teco-kit/Jennisense/README

A modularized open hardware, sensor drivers based on contiki for the JN51xx µController. A detailed description and how-to can be found in the wiki (see link below).
http://github.com/teco-kit/Jennisense/wiki
