teco-kit/Jennisense/hardware/jnode/jnode_v34.html

Stückliste exportiert aus /home/phil/teco/jennisense/hardware/jnode/jnode_v34.sch am 08.07.14 09:46

Qty | Value | Device | Package | Parts | Description | ARROW | DIGIKEY | FARNELL | MOUSER | PLACE
1 | | JENNIC_JN51XXSMDTH | JN5148_SMDTH | IC1 | JN5139-xxx-M00xxx, Farnell: 1500175 | | 616-1045-1-ND | | | no
1 | | JUMPER-2SMD-NC | SJ_2S | JP2 | Jumper
1 | | JUMPER-2SMD-NO | SJ_2S-NO | JP1 | Jumper | | | | | no
3 | | LEDGL100MD1MP1 | GL100MD1MP1 | LED3; LED4; LED5 | LED | | | http://de.farnell.com/sharp/gl100md1mp1/ir-emitter-smd-940nm/dp/9707816?Ntt=970-7816 | | no
1 | | MOLEX_47309-2651NEW | MOLEX_47309-2651 | MICRO_SD1 | | | WM3974CT-ND
6 | 0.1µF | CAP0402-CAP | 0402-CAP | C2; C5; C6; C8; C12; C14 | Capacitor | | 490-1318-1-ND
3 | 0.1µF | CAP0402-CAP | 0402-CAP | C4; C13; C18 | Capacitor | | 490-1318-1-ND | | | no
1 | 0.22µF | CAP0402-CAP | 0402-CAP | C11 | Capacitor | | 399-4886-1-ND
1 | 1.5M | RESISTOR0402-RES | 0402-RES | R7 | Resistor | | 311-1.5MJRCT-ND
1 | 1.8k | RESISTOR0402-RES | 0402-RES | R2 | Resistor | | 311-1.8KJRCT-ND
3 | 10k | RESISTOR0402-RES | 0402-RES | R6; R10; R11 | Resistor | | RHM10.0KCDCT-ND
1 | 10pF | CAP0402-CAP | 0402-CAP | C10 | Capacitor | | 311-1014-1-ND
6 | 10µF | CAP0603-CAP | 0603-CAP | C9; C15; C17; C19; C20; C22 | Capacitor | | 445-7454-1-ND
1 | 1M | RESISTOR0402-RES | 0402-RES | R9 | Resistor | | 311-1.00MLRCT-ND
1 | 1µF | CAP0402-CAP | 0402-CAP | C7 | Capacitor | | 490-1320-1-ND
1 | 2.2µF | CAP0402-CAP | 0402-CAP | C21 | Capacitor | | 445-7396-1-ND
2 | 22 | RESISTOR0402-RES | 0402-RES | R4; R5 | Resistor | | 311-22JRCT-ND
2 | 3k3 | RESISTOR0402-RES | 0402-RES | R18; R19 | Resistor | | 1276-3460-1-ND
1 | 4.7µF | CAP0402-CAP | 0402-CAP | C3 | Capacitor | | 1276-1056-1-ND
1 | 4.7µH | SPARKFUN_INDUCTOR | MLP2012 | L1 | Inductors | | 445-6366-1-ND
1 | 470nF | CAP0402-CAP | 0402-CAP | C1 | Capacitor | | 587-1230-1-ND
3 | 510 | RESISTOR0402-RES | 0402-RES | R15; R16; R17 | Resistor | | | | | no
1 | 560K | RESISTOR0402-RES | 0402-RES | R8 | Resistor | | P560KLCT-ND
2 | 680 | RESISTOR0402-RES | 0402-RES | R3; R12 | Resistor | | RHM680CDCT-ND
1 | ATMEGA32U4-AUQFN44 | ATMEGA32U4-AUQFN44 | QFN44 | IC2 | | | ATMEGA32U4-MU-ND
1 | DMP2104LP-7 | DMP2104LP-7 | DFN1411-3 | T1 | | | DMP2104LPDICT-ND
1 | GREEN | LEDCHIP-LED0402 | CHIP-LED0402 | LED2 | LED | | 754-1127-1-ND
1 | LSM9D | LSM9D | LGA4X4 | U2 | | http://components.arrow.com/part/search/lsm9ds0 | http://www.digikey.com/product-detail/en/LSM9DS0TR/497-13902-1-ND/4311634 | | http://de.mouser.com/ProductDetail/STMicroelectronics/LSM9DS0TR/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
1 | LTC2942-1 | LTC2942-1 | DFN6 | U4 | LTC2942-1/2 | | LTC2942IDCB-1#TRMPBFCT-ND
1 | LTC3553 | LTC3553 | QFN20 | IC3 | | | LTC3553EUD#PBF-ND
1 | MPL3115A2 | MPL3115A2 | LGA8 | IC6 | | | MPL3115A2-ND
1 | RED | LEDCHIP-LED0402 | CHIP-LED0402 | LED1 | LED | | 754-1128-1-ND
1 | RESONATORPRQC-S | RESONATORPRQC-S | PRQC | U6 | Ceramic Resonator with caps | | 478-5420-1-ND
1 | SFV5R | SFV5R | SFV5R | U3 | | | 609-4330-1-ND
1 | SHT21 | SHT21 | DFN300X300X110-7N | U1 | SENSOR, HUMIDITY & TEMP | | | http://de.farnell.com/sensirion/sht21/sensor-feuchte-temp-3x3mm-2/dp/1855468?Ntt=1855468
1 | TACTILE_SWITCH | TACTILE_SWITCH | EVQ-PUK02K | BTN_PWR | collection of tactile switches | | P10852SCT-ND
1 | TECO-LOGO | TECO-LOGO | TECO-LOGO | U$9 | | | | | | no
1 | USBMICROB-XT | USBMICROB-XT | USB-MICROB-XT | X1 | USB Connectors | | H11635CT-ND
1 | VCNL4000 | VCNL4000 | VNCL4000 | VCNL4010 | | | VCNL4010-GS08CT-ND
