teco-kit/Jennisense/hardware/jnode/jnode_v3_links.htm

Stückliste exportiert aus /home/phil/teco/jennisense/hardware/jnode/jnode_v3.sch am 16.08.12 17:53

Qty | Value | Device | Package | Parts | Description | DIGIKEY | FARNELL | FUTUREELECTRIC | IPODCONN | MF | MPN | OC_FARNELL | OC_NEWARK | PLACE | TECO
1 | | JUMPER-2SMD-NO | SJ_2S-NO | JP1 | Jumper
3 | | LEDGL100MD1MP1 | GL100MD1MP1 | LED3, LED4, LED5 | LED | | link (http://de.farnell.com/sharp/gl100md1mp1/ir-emitter-smd-940nm/dp/9707816?Ntt=970-7816) | | | | | | | no
6 | 0.1µF | CAP0402-CAP | 0402-CAP | C2, C4, C8, C12, C14, C18 | Capacitor | link (http://search.digikey.com/scripts/DkSearch/dksus.dll?Detail&name=445-7396-1-ND) | link (http://de.farnell.com/multicomp/mcca000051/mlcc-04025v-16v-100nf/dp/1758897) | | | | | | | | yes
1 | 0.22µF | CAP0402-CAP | 0402-CAP | C16 | Capacitor | link (http://search.digikey.com/scripts/DkSearch/dksus.dll?Detail&name=311-1350-1-ND) | link (http://de.farnell.com/multicomp/mcca000036/mlcc-04025v-10v-220nf/dp/1758880) | | | | | | | | yes
1 | 1.5M | RESISTOR0402-RES | 0402-RES | R7 | Resistor | link (http://search.digikey.com/scripts/DkSearch/dksus.dll?Detail&name=541-2.20MLCT-ND) | link (http://de.farnell.com/yageo-phycomp/rc0402fr-071m8l/widerstand-0402-0-063w-1-1m8/dp/1458753) | | | | | | | | yes
1 | 1.8k | RESISTOR0402-RES | 0402-RES | R2 | Resistor | link (http://search.digikey.com/scripts/DkSearch/dksus.dll?Detail&name=311-1.8KJRCT-ND) | link (http://de.farnell.com/vishay-draloric/crcw04021k80fkeahp/widerstand-0402-1-1k80/dp/1738853) | | | | | | | | yes
4 | 10k | RESISTOR0402-RES | 0402-RES | R1, R6, R10, R11 | Resistor | link (http://search.digikey.com/scripts/DkSearch/dksus.dll?Detail&name=311-10KJRCT-ND) | link (http://de.farnell.com/bourns/cr0603-jw-103elf/widerstand-0603-10k-5-0-1w/dp/2008360) | | | | | | | | yes
1 | 10nF | CAP0402-CAP | 0402-CAP | C11 | Capacitor | link (http://search.digikey.com/scripts/DkSearch/dksus.dll?Detail&name=478-1114-1-ND) | link (http://de.farnell.com/multicomp/mcca000076/mlcc-0402-x7r-25v-10nf/dp/1758924) | | | | | | | | yes
1 | 10pF | CAP0402-CAP | 0402-CAP | C10 | Capacitor | link (http://search.digikey.com/scripts/DkSearch/dksus.dll?Detail&name=311-1014-1-ND) | link (http://de.farnell.com/multicomp/mcca000091/mlcc-0402-np0-50v-10pf/dp/1758941) | | | | | | | | yes
4 | 10µF | CAP0603-CAP | 0603-CAP | C9, C13, C17, C22 | Capacitor | link (http://search.digikey.com/scripts/DkSearch/dksus.dll?Detail&name=445-7454-1-ND) | link (http://de.farnell.com/multicomp/mcca000517/mlcc-0603-x5r-6-3v-10uf/dp/1759393) | | | | | | | | yes
2 | 10µF / near | CAP0603-CAP | 0603-CAP | C19, C20 | Capacitor | link (http://search.digikey.com/scripts/DkSearch/dksus.dll?Detail&name=445-7454-1-ND) | link (http://de.farnell.com/multicomp/mcca000517/mlcc-0603-x5r-6-3v-10uf/dp/1759393) | | | | | | | | yes
2 | 1M | RESISTOR0402-RES | 0402-RES | R9, R14 | Resistor | link (http://search.digikey.com/scripts/DkSearch/dksus.dll?Detail&name=311-10KJRCT-ND) | link (http://de.farnell.com/bourns/cr0603-jw-103elf/widerstand-0603-10k-5-0-1w/dp/2008360) | | | | | | | | yes
3 | 1µF | CAP0402-CAP | 0402-CAP | C5, C6, C7 | Capacitor | link (http://search.digikey.com/scripts/DkSearch/dksus.dll?Detail&name=490-1320-1-ND) | link (http://de.farnell.com/multicomp/mcca000500/mlcc-0402-x5r-6-3v-1uf/dp/1759375) | | | | | | | | yes
1 | 2.2M | RESISTOR | 0805 | R13 | Resistor | link (http://search.digikey.com/scripts/DkSearch/dksus.dll?Detail&name=541-2.20MLCT-ND) | link (http://de.farnell.com/te-connectivity-cgs/rh73u2a2m2jtd/widerstand-0805-2m2/dp/1174056)
1 | 2.2µF / near | CAP0402-CAP | 0402-CAP | C21 | Capacitor | link (http://search.digikey.com/scripts/DkSearch/dksus.dll?Detail&name=445-7396-1-ND) | link (http://de.farnell.com/multicomp/mcca000501/mlcc-0402-x5r-6-3v-2-2uf/dp/1759376RL) | | | | | | | | yes
2 | 22 | RESISTOR0402-RES | 0402-RES | R4, R5 | Resistor | link (http://search.digikey.com/scripts/DkSearch/dksus.dll?Detail&name=311-22JRCT-ND) | link (http://de.farnell.com/multicomp/mc-0-0625w-0402-1-22r/widerstand-0402-1-22r/dp/1357998)
2 | 3k3 | RESISTOR0402-RES | 0402-RES | R18, R19 | Resistor | link (http://search.digikey.com/scripts/DkSearch/dksus.dll?Detail&name=541-2.20MLCT-ND) | link (http://de.farnell.com/bourns/cr0603-jw-103elf/widerstand-0603-10k-5-0-1w/dp/2008360) | | | | | | | no | yes
1 | 4.7µF | CAP0402-CAP | 0402-CAP | C15 | Capacitor | link (http://search.digikey.com/scripts/DkSearch/dksus.dll?Detail&name=490-5408-1-ND) | link (http://de.farnell.com/avx/04024d475mat2a/kondensator-0402-x5r-4v-4-7uf/dp/1833801) | | | | | | | | yes
1 | 4.7µH | SPARKFUN_INDUCTOR | MLP2012 | L1 | Inductors | link (http://search.digikey.com/scripts/DkSearch/dksus.dll?Detail&name=445-6366-1-ND)
2 | 470nF | CAP0402-CAP | 0402-CAP | C1, C3 | Capacitor | link (http://search.digikey.com/scripts/DkSearch/dksus.dll?Detail&name=311-1334-1-ND) | link (http://de.farnell.com/multicomp/mcca000510/mlcc-0402-x5r-16v-0-047uf/dp/1759386) | | | | | | | | yes
3 | 510 | RESISTOR0402-RES | 0402-RES | R15, R16, R17 | Resistor | | | | | | | | | no
1 | 53261-03 | 53261-03 | 53261-03 | X2 | CONNECTOR | | | | link (http://www.batteryspace.com/li-ionbatterymodule37v500mahwithpcb043144foripodmini185wh.aspx) | MOLEX | 53261-0390 | 1125359 | 57H5006
1 | 560K | RESISTOR0402-RES | 0402-RES | R8 | Resistor | link (http://search.digikey.com/scripts/DkSearch/dksus.dll?Detail&name=RMCF0402FT698KCT-ND) | link (http://de.farnell.com/yageo-phycomp/rc0402jr-07560kl/widerstand-rc31-0402-560k/dp/9233091)
2 | 680 | RESISTOR0402-RES | 0402-RES | R3, R12 | Resistor | link (http://search.digikey.com/scripts/DkSearch/dksus.dll?Detail&name=311-39JRCT-ND)
1 | ATMEGA32U4-AUQFN44 | ATMEGA32U4-AUQFN44 | QFN44 | IC2 | | link (http://search.digikey.com/scripts/DkSearch/dksus.dll?Detail&name=ATMEGA32U4-MU-ND)
1 | DMP2104LP-7 | DMP2104LP-7 | DFN1411-3 | T1
1 | GREEN | LEDCHIP-LED0402 | CHIP-LED0402 | LED2 | LED | link (http://search.digikey.com/scripts/DkSearch/dksus.dll?Detail&name=754-1128-1-ND) | | | | | | | | | yes
1 | JENNIC_JN5139 | JENNIC_JN51XXSMDTH | JN5148_SMDTH | IC1 | JN5139-xxx-M00xxx, Farnell: 1500175 | link (http://search.digikey.com/de/de/products/JN5148%2F001M00T,534/616-1045-1-ND/2139684) | | link (http://de.futureelectronics.com/de/technologies/semiconductors/microcontrollers/32-bit/Seiten/6004977-JN5148-001M00T,534.aspx) | | | | | | | yes
1 | L3G4200D | L3G4200D | LGA16-4X4 | IC5 | L3G4200D Three-axis, digital output gyroscope | link (http://search.digikey.com/scripts/DkSearch/dksus.dll?Detail&name=497-11071-1-ND) | link (http://de.farnell.com/stmicroelectronics/l3g4200d/gyro-mems-3achsen-16llga-16lga/dp/1872924?Ntt=l3g4200) | link (http://de.futureelectronics.com/de/technologies/semiconductors/analog/sensors/motion/Seiten/2007852-L3G4200DTR.aspx)
1 | LSM303DLM | LSM303LGA28_LONG | LGA28 | IC4 | LSM303DLH | link (http://search.digikey.com/scripts/DkSearch/dksus.dll?Detail&name=497-11240-1-ND) | | link (http://de.futureelectronics.com/de/technologies/semiconductors/analog/sensors/accelerometers/Seiten/8010012-LSM303DLMTR.aspx)
1 | LTC3553 | LTC3553 | QFN20 | IC3 | | link (http://search.digikey.com/scripts/DkSearch/dksus.dll?Detail&name=LTC3553EUD%23PBF-ND)
1 | MPL115A | MPL115A | LGA8 | IC6 | MPL115A1 (SPI) and MPL115A2 (I2C) | link (http://search.digikey.com/scripts/DkSearch/dksus.dll?Detail&name=MPL115A2T1CT-ND) | | | | | | | | | yes
1 | RED | LEDCHIP-LED0402 | CHIP-LED0402 | LED1 | LED | link (http://search.digikey.com/scripts/DkSearch/dksus.dll?Detail&name=754-1128-1-ND) | | | | | | | | | yes
1 | RESONATORPRQC-S | RESONATORPRQC-S | PRQC | U$6 | Ceramic Resonator with caps | link (http://search.digikey.com/scripts/DkSearch/dksus.dll?Detail&name=478-5420-1-ND)
1 | SENSOR_BOARD_MOLEX_47309-2651'NEW' | SENSOR_BOARD_MOLEX_47309-2651'NEW' | SENSOR_BOARD_MOLEX_47309-2651 | MICRO_SD1 | | link (http://search.digikey.com/scripts/DkSearch/dksus.dll?Detail&name=WM3974CT-ND) | | | | | | | | | yes
1 | SONDER_H_VIBRATIONSSCHALTER | SONDER_H_VIBRATIONSSCHALTER | SONDER_H_VIBSCHALTER | SW1 | Vibrationsschalter von FZK
1 | TACTILE_SWITCH | TACTILE_SWITCH | EVQ-PUK02K | BTN_PWR | collection of tactile switches | link (http://search.digikey.com/scripts/DkSearch/dksus.dll?Detail&name=P10852SCT-ND)
1 | TECO-LOGO | TECO-LOGO | TECO-LOGO | U$9
1 | USB-MICROB | USB-MICROB | USB-MICROB | X1 | USB Connectors | link (http://search.digikey.com/scripts/DkSearch/dksus.dll?Detail&name=H11635CT-ND)
1 | VCNL4000 | VCNL4000 | VNCL4000 | VCNL4000 | | link (http://search.digikey.com/scripts/DkSearch/dksus.dll?Detail&name=751-1505-1-ND) | | | | | | | | | yes
