teco-kit/Jennisense/hardware/jncc3000/jncc3000-bom.pdf

19.4.2014 | jncc3000_links.html
file:///home/phil/teco/jennisense/hardware/jncc3000/jncc3000_links.html | 1/1

Stückliste exportiert aus /home/phil/teco/jennisense/hardware/jncc3000/jncc3000.sch am 19.04.14 13:14

Part Value Device | Package | Description | COMMENT DIGIKEY MOUSER PLACE
ANT1 AT8010 AT8010 | AT8010 | AT8010 Series Multilayer Chip Antenna | link (http://www.digikey.de/product-detail/en/2500AT44M0400E/712-1403-1-ND/1840081) | link (http://de.mouser.com/ProductDetail/Johanson/2500AT44M0400E/)
C3 | 100nF C-EUC0603 | C0603 | CAPACITOR, European symbol | link (http://www.digikey.de/product-detail/en/CC0603KRX7R8BB104/311-1341-1-ND/2103125) | link (http://de.mouser.com/ProductDetail/Vishay-Vitramon/VJ0603Y104JXJCW1BC/)
C4 | 0.8pF C-EUC0603 | C0603 | CAPACITOR, European symbol | RF Capacitor
| | | | link (http://www.digikey.de/product-detail/en/251R14S0R8BV4T/712-1305-1-ND/1786767) | link (http://de.mouser.com/ProductDetail/Johanson/251R14S0R8BV4T/)
L1 | 3.3nH INDUCTOR0603 | 0603 | Inductors | RF Inductor link (http://www.digikey.de/product-detail/en/L-14C3N3SV4T/712-1428-1-ND/1914878) | link (http://de.mouser.com/ProductDetail/Johanson/L-14C3N3SV4T/)
U$2 | JENNIC_JN51XXTH JN5139_TH | JN5139-xxx-M00xxx, Farnell: 1500175 | no
U1 | CC3000 | CC3000 | | link (http://www.digikey.de/product-detail/en/CC3000MODR/296-35512-1-ND/3768439) | link (http://de.mouser.com/ProductDetail/Texas-Instruments/CC3000MOD/?qs=sGAEpiMZZMul4LbMdexInYO9dzLxESeK)
U4 | NL17SZ125SOT553 SOT-553 | link (http://www.digikey.de/product-detail/en/NL17SZ125XV5T2G/NL17SZ125XV5T2GOSCT-ND/3462428) | link (http://de.mouser.com/ProductDetail/ON-Semiconductor/NL17SZ125XV5T2G/)
X2 | IPEX-20279-001E | IPEX-20279- 001E | Ultra Miniature Coaxial SMT RF Receptacle
no
