teco-kit/Jennisense/hardware/jnode/case.stl

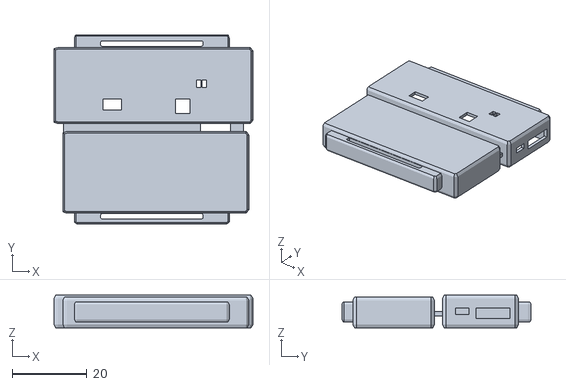
[picture p1: CAD file, 2014-07-05]
hardware/jnode/case.stl
53.3 x 50.7 x 8.73
