teco-kit/Jennisense/hardware/jncc3000/jncc3000-schematic.pdf

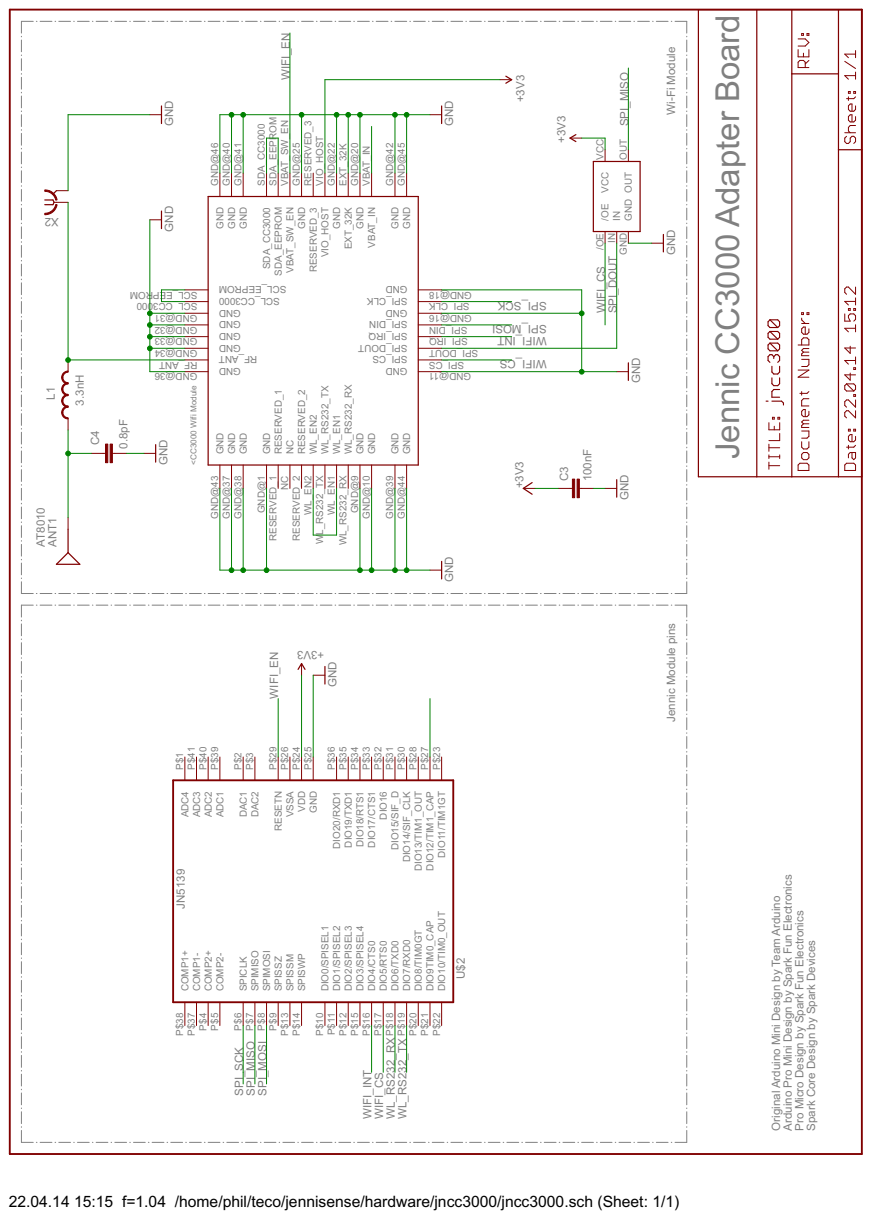
[picture p2: page 1]

Wi-Fi Module Jennic Module pins

GND GND@40 GND GND@41

GND GND@20 GND GND@22 GND GND@25

GND GND@44 GND GND@45

IN OUT OUT VCC

GND GND@9 GND GND@10 DNG

GND GND@37 GND GND@38

Arduino Arduino Pro Mini Design by Spark Fun Electronics Pro Micro Design by Spark Fun Electronics Spark Core Design by Spark Devices J

Original Arduino Mini Design by Team

22.04.14 15:15 f=1.04 /home/phil/teco/jennisense/hardware/jncc3000/jncc3000.sch (Sheet: 1/1)
