teco-kit/Jennisense/hardware/jncc3000/jncc3000-board.pdf

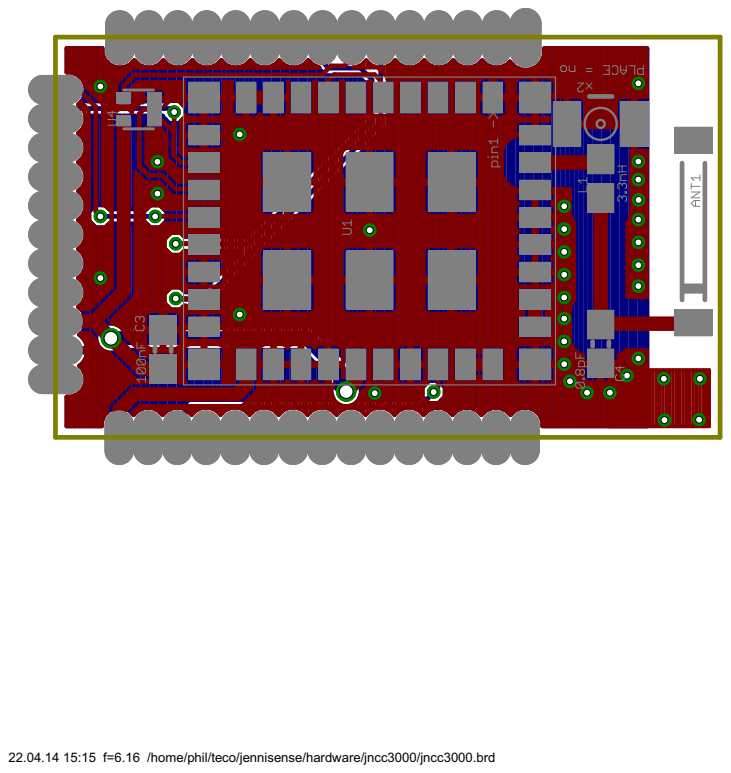
[picture p3: page 1]

22.04.14 15:15 f=6.16 /home/phil/teco/jennisense/hardware/jncc3000/jncc3000.brd
