teco-kit/Jennisense/hardware/jncc3000/jncc3000-assembly.pdf

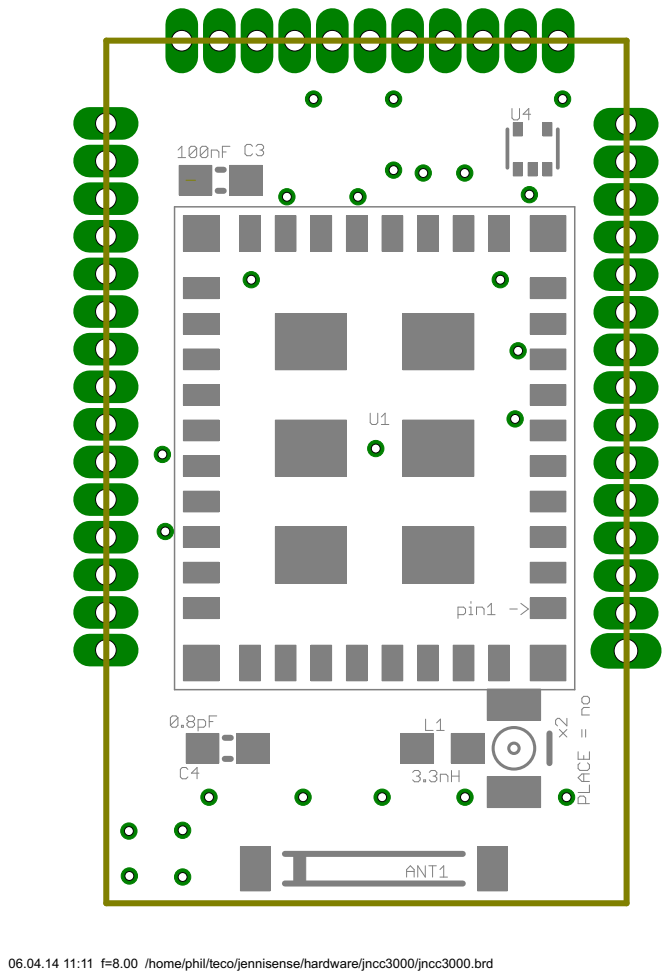
[picture p4: page 1]

06.04.14 11:11 f=8.00 /home/phil/teco/jennisense/hardware/jncc3000/jncc3000.brd
