teco-kit/Jennisense/hardware/jnode/jnode_v34.brd

## EAGLE design hardware/jnode/jnode_v34.brd (2014-08-19)

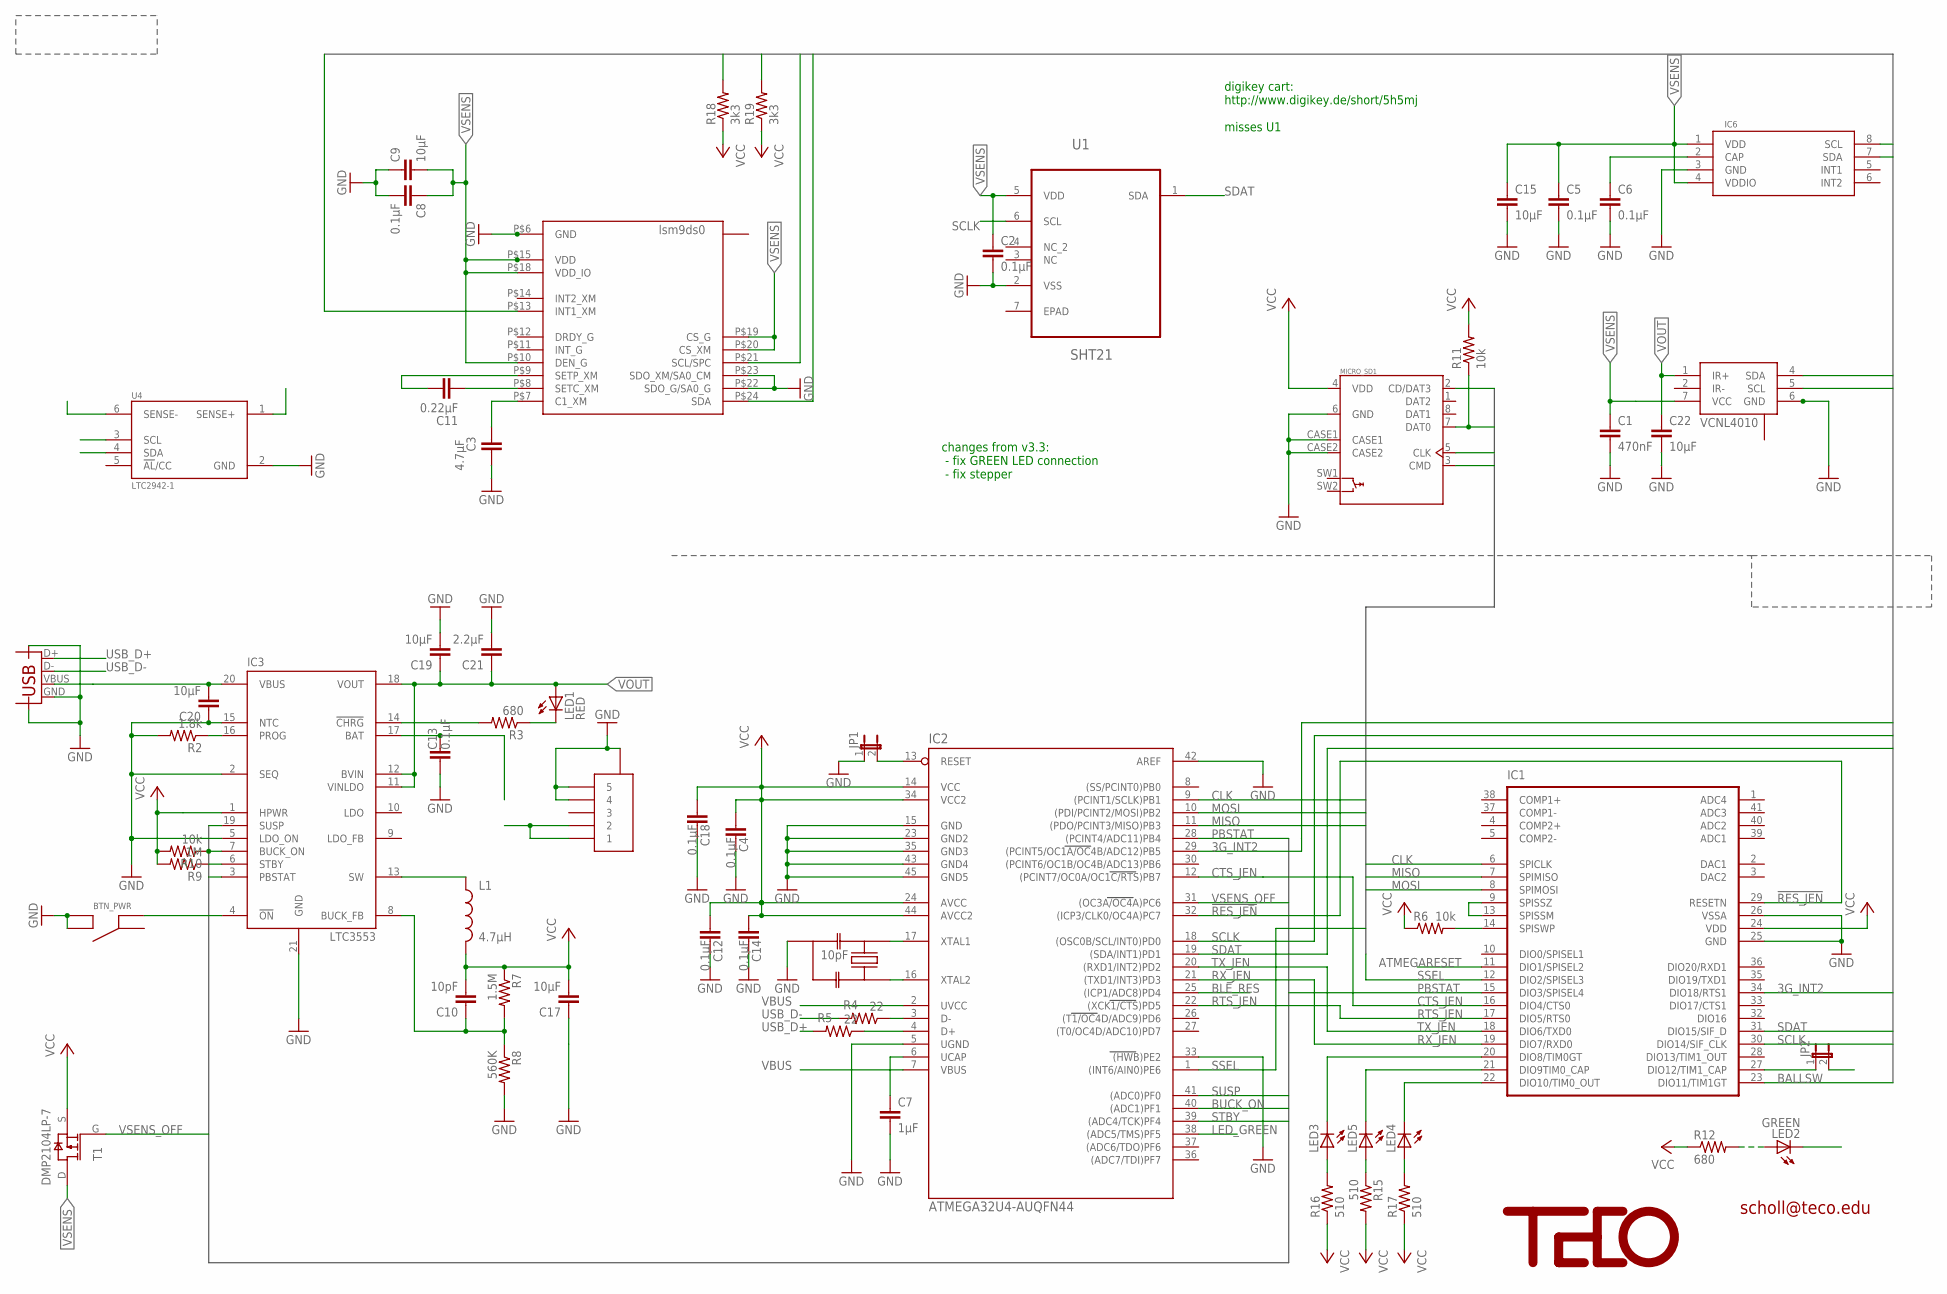
[picture p5: schematic jnode_v34.sch]

Parts:
BTN_PWR: TACTILE_SWITCH; EVQ-PUK02K; DIGIKEY P10852SCT-ND
C1: 470nF; 0402-CAP; DIGIKEY 587-1230-1-ND
C2, C4, C5, C6, C8, C12, C13, C14, C18: 0.1µF; 0402-CAP; DIGIKEY 490-1318-1-ND
C3: 4.7µF; 0402-CAP; DIGIKEY 1276-1056-1-ND
C7: 1µF; 0402-CAP; DIGIKEY 490-1320-1-ND
C9, C15, C17, C19, C20, C22: 10µF; 0603-CAP; DIGIKEY 445-7454-1-ND
C10: 10pF; 0402-CAP; DIGIKEY 311-1014-1-ND
C11: 0.22µF; 0402-CAP; DIGIKEY 399-4886-1-ND
C21: 2.2µF; 0402-CAP; DIGIKEY 445-7396-1-ND
IC1: JENNIC_JN51XXSMDTH; JN5148_SMDTH; DIGIKEY 616-1045-1-ND
IC2: ATMEGA32U4-AUQFN44; QFN44; DIGIKEY ATMEGA32U4-MU-ND
IC3: LTC3553; QFN20; DIGIKEY LTC3553EUD#PBF-ND
IC6: MPL3115A2; LGA8
JP1: JUMPER-2SMD-NO; SJ_2S-NO
JP2: JUMPER-2SMD-NC; SJ_2S
L1: 4.7µH; MLP2012; DIGIKEY 445-6366-1-ND
LED1: RED; CHIP-LED0402; DIGIKEY 754-1128-1-ND
LED2: GREEN; CHIP-LED0402; DIGIKEY 754-1127-1-ND
LED3, LED4, LED5: LEDGL100MD1MP1; GL100MD1MP1
MICRO_SD1: MOLEX_47309-2651NEW; MOLEX_47309-2651; DIGIKEY WM3974CT-ND
R2: 1.8k; 0402-RES; DIGIKEY 311-1.8KJRCT-ND
R3, R12: 680; 0402-RES; DIGIKEY RHM680CDCT-ND
R4, R5: 22; 0402-RES; DIGIKEY 311-22JRCT-ND
R6, R10, R11: 10k; 0402-RES; DIGIKEY RHM10.0KCDCT-ND
R7: 1.5M; 0402-RES; DIGIKEY 311-1.5MJRCT-ND
R8: 560K; 0402-RES; DIGIKEY P560KLCT-ND
R9: 1M; 0402-RES; DIGIKEY 311-1.00MLRCT-ND
R15, R16, R17: 510; 0402-RES
R18, R19: 3k3; 0402-RES; DIGIKEY 1276-3460-1-ND
T1: DMP2104LP-7; DFN1411-3; DIGIKEY DMP2104LPDICT-ND
U1: SHT21; DFN300X300X110-7N
U2: LSM9D; LGA4X4
U3: SFV5R; DIGIKEY 609-4330-1-ND
U4: LTC2942-1; DFN6; DIGIKEY LTC2942IDCB-1#TRMPBFCT-ND
U6: RESONATORPRQC-S; PRQC; DIGIKEY 478-5420-1-ND
U$9: TECO-LOGO
VCNL4010: VCNL4000; VNCL4000; DIGIKEY VCNL4010-GS08CT-ND
X1: USBMICROB-XT; USB-MICROB-XT; DIGIKEY H11635CT-ND

Connections:
3G_INT2: IC1.34 (DIO18/RTS1), IC2.29 ((PCINT5/OC1A/OC4B/ADC12)PB5), U2.P$13 (INT1_XM)
!RES_JEN: IC1.29 (RESETN), IC2.32 ((ICP3/CLK0/OC4A)PC7)
ATMEGARESET: IC1.11 (DIO1/SPISEL2), IC2.13 (RESET), JP1.2
BALLSW: IC1.23 (DIO11/TIM1GT)
BLE_RES: IC2.25 ((ICP1/ADC8)PD4)
BUCK_FB: C10.1, IC3.8 (BUCK_FB), R7.2, R8.1
BUCK_ON: IC2.40 ((ADC1)PF1), IC3.7 (BUCK_ON), R10.1
CLK: IC1.6 (SPICLK), IC2.9 ((PCINT1/SCLK)PB1), MICRO_SD1.5 (CLK)
CTS_JEN: IC1.16 (DIO4/CTS0), IC2.12 ((PCINT7/OC0A/OC1C/RTS)PB7)
GND: BTN_PWR.2 (B), BTN_PWR.4 (B), C1.2, C2.2, C3.2, C4.1, C5.2, C6.2, C7.2, C8.2, C9.1, C12.1, C13.2, C14.1, C15.2, C17.1, C18.1, C19.2, C20.1, C21.2, C22.2, IC1.25 (GND), IC1.26 (VSSA), IC2.5 (UGND), IC2.15 (GND), IC2.23 (GND2), IC2.33 ((HWB)PE2), IC2.35 (GND3), IC2.42 (AREF), IC2.43 (GND4), IC2.45 (GND5), IC3.2 (SEQ), IC3.5 (LDO_ON), IC3.15 (NTC), IC3.21 (GND), IC6.3 (GND), JP1.1, MICRO_SD1.6 (GND), MICRO_SD1.CASE1, MICRO_SD1.CASE2, R2.2, R8.2, U1.2 (VSS), U2.P$5 (GND), U2.P$6 (GND), U2.P$22 (SDO_G/SA0_G), U2.P$23 (SDO_XM/SA0_CM), U3.P$4 (4), U3.P$5 (5), U3.P$6, U3.P$7, U4.2 (GND), U6.GND, VCNL4010.6 (GND), VCNL4010.12 (GND), X1.GND, X1.GND@2 (CASE), X1.GND@3 (CASE)
LED_GREEN: IC2.38 ((ADC5/TMS)PF5), LED2.P$2 (C)
MISO: IC1.7 (SPIMISO), IC2.11 ((PDO/PCINT3/MISO)PB3), MICRO_SD1.7 (DAT0), R11.1
MOSI: IC1.8 (SPIMOSI), IC2.10 ((PDI/PCINT2/MOSI)PB2), MICRO_SD1.3 (CMD)
unnamed: IC2.3 (D-), R4.1
unnamed: C3.1, U2.P$7 (C1_XM)
unnamed: IC2.4 (D+), R5.1
unnamed: C7.1, IC2.6 (UCAP)
unnamed: IC3.16 (PROG), R2.1
unnamed: VCNL4010.2 (IR-), VCNL4010.3 (IR-)
unnamed: C11.2, U2.P$8 (SETC_XM)
unnamed: C11.1, U2.P$9 (SETP_XM)
unnamed: BTN_PWR.3 (A), IC3.4 (!ON)
unnamed: C6.1, IC6.2 (CAP)
unnamed: LED1.P$2 (C), R3.1
unnamed: IC3.14 (!CHRG), R3.2
unnamed: IC1.9 (SPISSZ), IC1.13 (SPISSM)
unnamed: IC1.14 (SPISWP), R6.2
unnamed: IC2.17 (XTAL1), U6.2
unnamed: IC2.16 (XTAL2), U6.1
unnamed: IC1.27 (DIO12/TIM1_CAP), JP2.1
unnamed: LED2.P$1 (A), R12.2
unnamed: IC1.21 (DIO9TIM0_CAP), LED5.2 (C)
unnamed: IC1.20 (DIO8/TIM0GT), LED3.2 (C)
unnamed: LED3.1 (A), R16.2
unnamed: LED5.1 (A), R15.1
unnamed: IC1.22 (DIO10/TIM0_OUT), LED4.2 (C)
unnamed: LED4.1 (A), R17.2
PBSTAT: IC1.15 (DIO3/SPISEL4), IC2.28 ((PCINT4/ADC11)PB4), IC3.3 (PBSTAT)
RTS_JEN: IC1.17 (DIO5/RTS0), IC2.22 ((XCK1/CTS)PD5)
RX_JEN: IC1.19 (DIO7/RXD0), IC2.21 ((TXD1/INT3)PD3)
SCLK: IC1.30 (DIO14/SIF_CLK), IC2.18 ((OSC0B/SCL/INT0)PD0), IC6.8 (SCL), R19.2, U1.6 (SCL), U2.P$21 (SCL/SPC), U4.3 (SCL), VCNL4010.5 (SCL)
SDAT: IC1.31 (DIO15/SIF_D), IC2.19 ((SDA/INT1)PD1), IC6.7 (SDA), R18.2, U1.1 (SDA), U2.P$24 (SDA), U4.4 (SDA), VCNL4010.4 (SDA)
SENSE+: C13.1, IC3.17 (BAT), U4.1 (SENSE+)
SENSE-: JP2.2, U3.P$1 (1), U3.P$2 (2), U4.6 (SENSE-)
SSEL: IC1.12 (DIO2/SPISEL3), IC2.1 ((INT6/AIN0)PE6), MICRO_SD1.2 (CD/DAT3)
STBY: IC2.39 ((ADC4/TCK)PF4), IC3.6 (STBY), R9.1
SUSP: IC2.41 ((ADC0)PF0), IC3.19 (SUSP)
SW: IC3.13 (SW), L1.P$1 (1)
TX_JEN: IC1.18 (DIO6/TXD0), IC2.20 ((RXD1/INT2)PD2)
USB_D+: R5.2, X1.D+
USB_D-: R4.2, X1.D-
VBUS: C20.2, IC2.2 (UVCC), IC2.7 (VBUS), IC3.20 (VBUS), X1.VBUS
VCC: C4.2, C10.2, C12.2, C14.2, C17.2, C18.2, IC1.24 (VDD), IC2.14 (VCC), IC2.24 (AVCC), IC2.34 (VCC2), IC2.44 (AVCC2), IC3.1 (HPWR), L1.P$2 (2), MICRO_SD1.4 (VDD), R6.1, R7.1, R9.2, R10.2, R11.2, R12.1, R15.2, R16.1, R17.1, R18.1, R19.1, T1.S
VOUT: C19.1, C21.1, C22.1, IC3.11 (VINLDO), IC3.12 (BVIN), IC3.18 (VOUT), LED1.P$1 (A), VCNL4010.1 (IR+)
VSENS: C1.1, C2.1, C5.1, C8.1, C9.2, C15.1, IC6.1 (VDD), IC6.4 (VDDIO), T1.D, U1.5 (VDD), U2.P$10 (DEN_G), U2.P$15 (VDD), U2.P$16 (VDD), U2.P$17 (VDD), U2.P$18 (VDD_IO), U2.P$19 (CS_G), U2.P$20 (CS_XM), VCNL4010.7 (VCC)
VSENS_OFF: IC2.31 ((OC3A/OC4A)PC6), T1.G

Notes on the sheet:
scholl@teco.edu
10pF
digikey cart: http://www.digikey.de/short/5h5mj misses U1
changes from v3.3: - fix GREEN LED connection - fix stepper

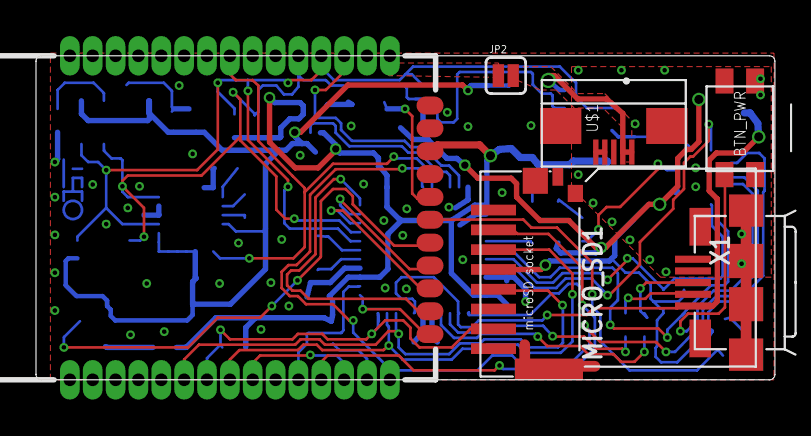
[picture p6: board jnode_v34.brd from above]

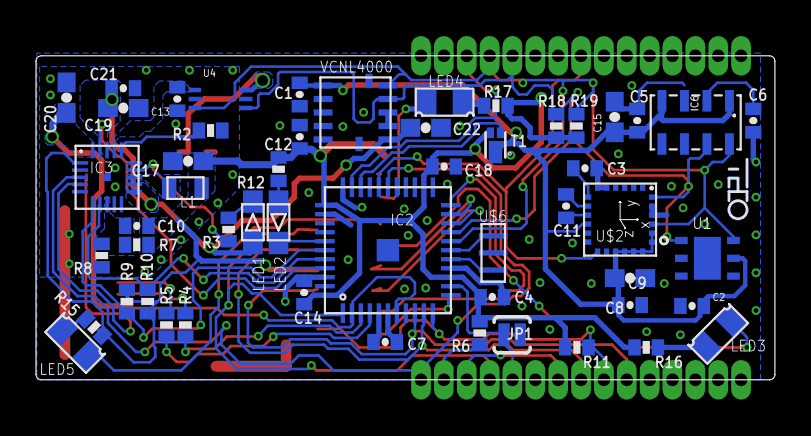
[picture p7: board jnode_v34.brd from below]

Board: 2 copper layers, 41.0 x 18.0 mm, 60 parts (54 on the bottom side), 54 nets.
