teco-kit/Jennisense/hardware/jnode/jncc3000.brd

## EAGLE design hardware/jnode/jncc3000.brd (2014-06-05)

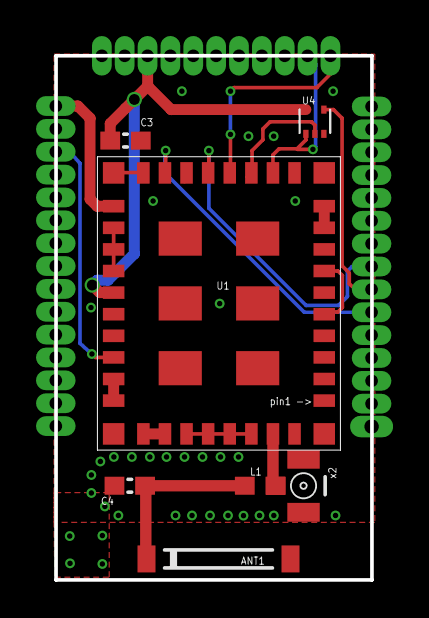
[picture p8: board jncc3000.brd from above]

Board: 2 copper layers, 17.6 x 29.1 mm, 8 parts (0 on the bottom side), 15 nets.

Parts:
ANT1: AT8010
C3: 100nF; C0603
C4: 0.8pF; C0603
L1: 3.3nH; 0603
U1: CC3000
U4: SOT-553
U$2: JN5139_TH
X2: IPEX-20279-001E

Connections:
+3V3: C3.1, U1.VIO_HOST, U4.VCC, U$2.P$24
GND: C3.2, C4.2, U1.EXT_32K, U1.GND@1, U1.GND@9, U1.GND@10, U1.GND@11, U1.GND@16, U1.GND@18, U1.GND@20, U1.GND@22, U1.GND@25, U1.GND@31, U1.GND@32, U1.GND@33, U1.GND@34, U1.GND@36, U1.GND@37, U1.GND@38, U1.GND@39, U1.GND@40, U1.GND@41, U1.GND@42, U1.GND@43, U1.GND@44, U1.GND@45, U1.GND@46, U4.GND, U$2.P$25, X2.2@1, X2.2@2
unnamed: L1.2, U1.RF_ANT, X2.1
unnamed: ANT1.SIG, C4.1, L1.1
unnamed: U1.SCL_CC3000, U1.SCL_EEPROM
unnamed: U1.WL_EN1, U1.WL_EN2
unnamed: U1.SDA_CC3000, U1.SDA_EEPROM
SPI_DOUT: U1.SPI_DOUT, U4.IN
SPI_MISO: U4.OUT, U$2.P$7
SPI_MOSI: U1.SPI_DIN, U$2.P$8
SPI_SCK: U1.SPI_CLK, U$2.P$6
VBAT: U1.VBAT_IN, U$2.P$27
WIFI_CS: U1.SPI_CS, U4./OE, U$2.P$17
WIFI_EN: U1.VBAT_SW_EN, U$2.P$29
WIFI_INT: U1.SPI_IRQ, U$2.P$16
