teco-kit/Jennisense/hardware/jnode/jnode_v1.brd

## EAGLE design hardware/jnode/jnode_v1.brd (2012-03-09, an earlier design)

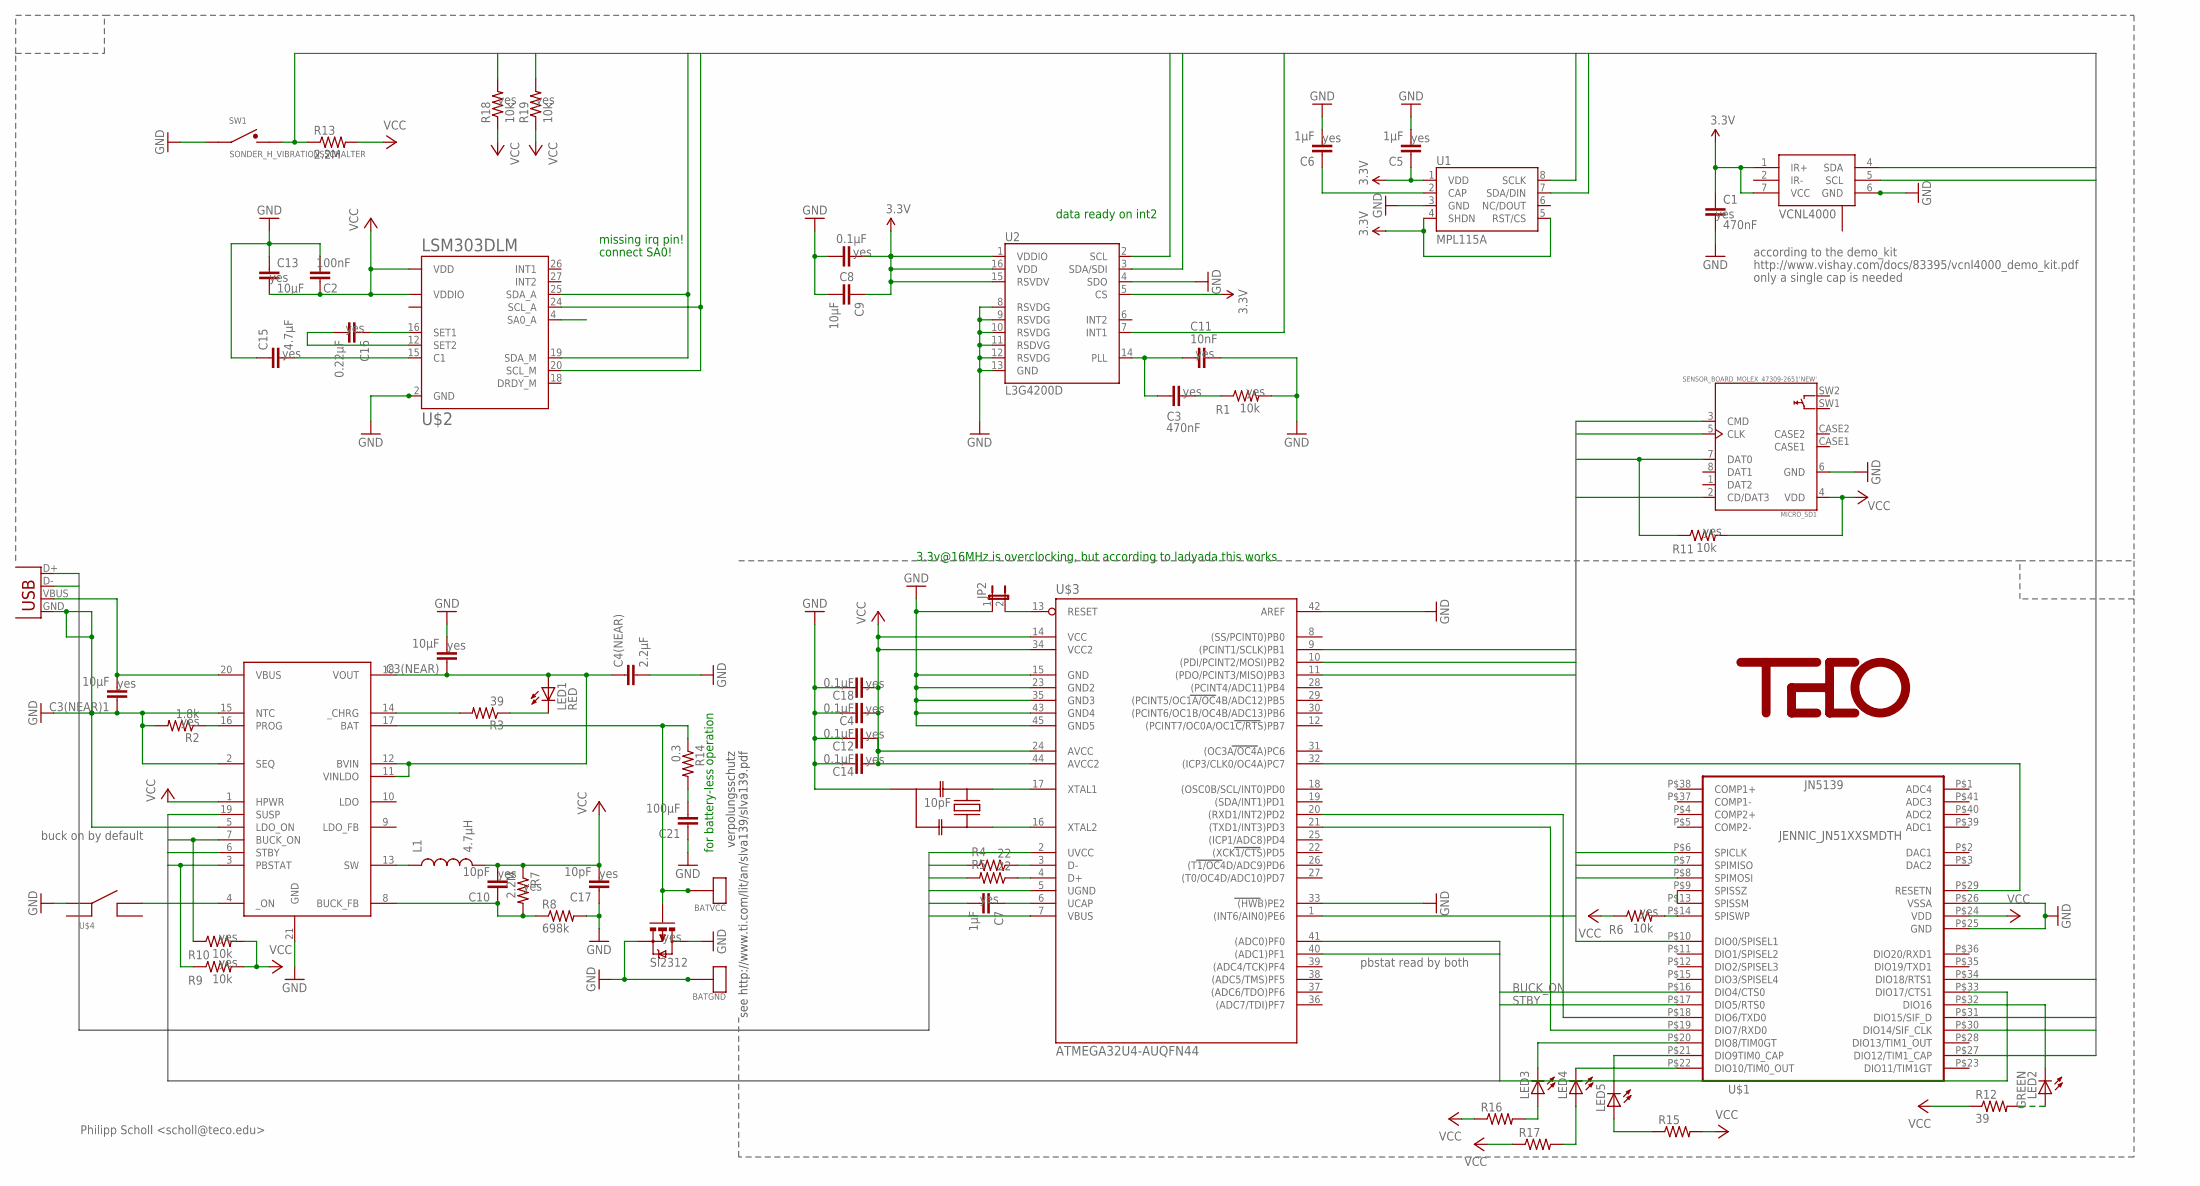
[picture p9: schematic jnode_v1.sch]

Parts:
BATGND: BATPAD
BATVCC: BATPAD
C1, C3: 470nF; 0402-CAP
C2: 100nF; 0402-CAP
C3(NEAR), C3(NEAR)1, C9, C13: 10µF; 0603-CAP
C4, C8, C12, C14, C18: 0.1µF; 0402-CAP
C4(NEAR): 2.2µF; 0402-CAP
C5, C6, C7: 1µF; 0402-CAP
C10, C17: 10pF; 0402-CAP
C11: 10nF; 0402-CAP
C15: 4.7µF; 0402-CAP
C16: 0.22µF; 0402-CAP
C21: 100µF; 0402-CAP
JP2: JUMPER-2SMD-NO; SJ_2S-NO
L1: 4.7µH; MLP2012
LED1: RED; CHIP-LED0402
LED2: GREEN; CHIP-LED0402
LED3, LED4, LED5: LEDGL100MD1MP1; GL100MD1MP1
MICRO_SD1: SENSOR_BOARD_MOLEX_47309-2651'NEW'; SENSOR_BOARD_MOLEX_47309-2651
R1, R6, R9, R10, R11, R18, R19: 10k; 0402-RES
R2: 1.8k; 0402-RES
R3, R12: 39; 0402-RES
R4, R5: 22; 0402-RES
R7: 2.2M; 0402-RES
R8: 698k; 0402-RES
R13: 2.2M; 0805
R14: 0.3; 0402-RES
R15, R16, R17: RESISTOR0402-RES; 0402-RES
SI2312: MOSFET-PCHANNELSMD; SOT23-3
SW1: SONDER_H_VIBRATIONSSCHALTER; SONDER_H_VIBSCHALTER
U1: MPL115A; LGA8
U2: L3G4200D; LGA16-4X4
U$1: JENNIC_JN51XXSMDTH; JN5148_SMDTH
U$2: LSM303DLM; LGA28
U$3: ATMEGA32U4-AUQFN44; QFN44
U$4: TACTILE_SWITCH; EVQ-PUK02K
U$5: LTC3553; QFN20
U$6: RESONATORPRQC-S; PRQC
U$9: TECO-LOGO
VCNL4000: VCNL4000; VNCL4000
X1: USB-MICROB

Connections:
BUCK_ON: R10.1, U$1.P$16 (DIO4/CTS0), U$5.7 (BUCK_ON)
CASE1: MICRO_SD1.CASE1
CASE2: MICRO_SD1.CASE2
CLK: MICRO_SD1.5 (CLK), U$1.P$6 (SPICLK), U$3.9 ((PCINT1/SCLK)PB1)
D+: R5.2, X1.D+
D-: R4.2, X1.D-
GND: BATGND.1 (134), BATGND.2 (PIN), C1.2, C2.2, C3(NEAR).2, C3(NEAR)1.1, C4.1, C4(NEAR).2, C5.2, C6.2, C7.2, C8.1, C9.2, C11.1, C12.1, C13.1, C14.1, C15.1, C17.1, C18.1, C21.1, JP2.1, MICRO_SD1.6 (GND), R1.2, R2.2, R8.2, SI2312.2 (S), SI2312.3 (D), SW1.1, U1.3 (GND), U2.4 (SDO), U2.8 (RSVDG), U2.9 (RSVDG), U2.10 (RSVDG), U2.11 (RSDVG), U2.12 (RSVDG), U2.13 (GND), U$1.P$25 (GND), U$1.P$26 (VSSA), U$2.1 (GND), U$2.2 (GND), U$2.8 (GND), U$2.10 (GND), U$2.28 (GND), U$3.5 (UGND), U$3.15 (GND), U$3.23 (GND2), U$3.33 ((HWB)PE2), U$3.35 (GND3), U$3.42 (AREF), U$3.43 (GND4), U$3.45 (GND5), U$4.1 (A), U$5.2 (SEQ), U$5.5 (LDO_ON), U$5.15 (NTC), U$5.21 (GND), U$6.GND, VCNL4000.6 (GND), VCNL4000.12 (GND), X1.GND
INT1: U2.7 (INT1), U$1.P$34 (DIO18/RTS1)
LEDRED: LED2.P$2 (C), U$1.P$32 (DIO16)
MISO: MICRO_SD1.7 (DAT0), R11.1, U$1.P$7 (SPIMISO), U$3.11 ((PDO/PCINT3/MISO)PB3)
MOSI: MICRO_SD1.3 (CMD), U$1.P$8 (SPIMOSI), U$3.10 ((PDI/PCINT2/MOSI)PB2)
unnamed: R4.1, U$3.3 (D-)
unnamed: C16.1, U$2.16 (SET1)
unnamed: R5.1, U$3.4 (D+)
unnamed: C7.1, U$3.6 (UCAP)
unnamed: R2.1, U$5.16 (PROG)
unnamed: VCNL4000.2 (IR-), VCNL4000.3 (IR-)
unnamed: C16.2, U$2.12 (SET2)
unnamed: U$4.4 (B), U$5.4 (_ON)
unnamed: C6.1, U1.2 (CAP)
unnamed: LED1.P$2 (C), R3.1
unnamed: R3.2, U$5.14 (_CHRG)
unnamed: U$1.P$9 (SPISSZ), U$1.P$13 (SPISSM)
unnamed: R6.2, U$1.P$14 (SPISWP)
unnamed: C3(NEAR).1, C4(NEAR).1, LED1.P$1 (A), U$5.11 (VINLDO), U$5.12 (BVIN), U$5.18 (VOUT)
unnamed: U$3.17 (XTAL1), U$6.2
unnamed: U$3.16 (XTAL2), U$6.1
unnamed: L1.P$1 (1), U$5.13 (SW)
unnamed: C10.1, R7.2, R8.1, U$5.8 (BUCK_FB)
unnamed: C21.2, R14.2
unnamed: U$1.P$18 (DIO6/TXD0), U$3.20 ((RXD1/INT2)PD2)
unnamed: U$1.P$19 (DIO7/RXD0), U$3.21 ((TXD1/INT3)PD3)
unnamed: U$1.P$29 (RESETN), U$3.32 ((ICP3/CLK0/OC4A)PC7)
unnamed: C15.2, U$2.15 (C1)
unnamed: C3.1, C11.2, U2.14 (PLL)
unnamed: C3.2, R1.1
unnamed: LED2.P$1 (A), R12.2
unnamed: LED5.2 (C), U$1.P$21 (DIO9TIM0_CAP)
unnamed: LED3.2 (C), U$1.P$20 (DIO8/TIM0GT)
unnamed: LED3.1 (A), R16.2
unnamed: LED5.1 (A), R15.1
unnamed: LED4.2 (C), U$1.P$22 (DIO10/TIM0_OUT)
unnamed: LED4.1 (A), R17.2
PBSTAT: R9.1, U$1.P$33 (DIO17/CTS1), U$3.40 ((ADC1)PF1), U$5.3 (PBSTAT)
RES: JP2.2, U$3.13 (RESET)
SCLK: R19.2, U1.8 (SCLK), U2.2 (SCL), U$1.P$30 (DIO14/SIF_CLK), U$2.20 (SCL_M), U$2.24 (SCL_A), VCNL4000.5 (SCL)
SDAT: R18.2, U1.7 (SDA/DIN), U2.3 (SDA/SDI), U$1.P$31 (DIO15/SIF_D), U$2.19 (SDA_M), U$2.25 (SDA_A), VCNL4000.4 (SDA)
SSEL: MICRO_SD1.2 (CD/DAT3), U$1.P$10 (DIO0/SPISEL1), U$3.1 ((INT6/AIN0)PE6)
STBY: U$1.P$17 (DIO5/RTS0), U$5.6 (STBY)
SUSP: U$3.41 ((ADC0)PF0), U$5.19 (SUSP)
TCAP: R13.1, SW1.2, U$1.P$27 (DIO12/TIM1_CAP)
VBATT: BATVCC.1 (134), BATVCC.2 (PIN), R14.1, SI2312.1 (G), U$5.17 (BAT)
VBUS: C3(NEAR)1.2, U$3.2 (UVCC), U$3.7 (VBUS), U$5.20 (VBUS), X1.VBUS
VCC: C1.1, C2.1, C4.2, C5.1, C8.2, C9.1, C10.2, C12.2, C13.2, C14.2, C17.2, C18.2, L1.P$2 (2), MICRO_SD1.4 (VDD), R6.1, R7.1, R9.2, R10.2, R11.2, R12.1, R13.2, R15.2, R16.1, R17.1, R18.1, R19.1, U1.1 (VDD), U1.4 (SHDN), U1.5 (RST/CS), U2.1 (VDDIO), U2.5 (CS), U2.15 (RSVDV), U2.16 (VDD), U$1.P$24 (VDD), U$2.7 (VDD), U$2.23 (VDDIO), U$3.14 (VCC), U$3.24 (AVCC), U$3.34 (VCC2), U$3.44 (AVCC2), U$5.1 (HPWR), VCNL4000.1 (IR+), VCNL4000.7 (VCC)

Notes on the sheet:
verpolungsschutz
see http://www.ti.com/lit/an/slva139/slva139.pdf
Philipp Scholl <scholl@teco.edu>
according to the demo_kit
http://www.vishay.com/docs/83395/vcnl4000_demo_kit.pdf
only a single cap is needed
3.3v@16MHz is overclocking, but according to ladyada this works
10pF
pbstat read by both
buck on by default
for battery-less operation
missing irq pin!
data ready on int2
connect SA0!

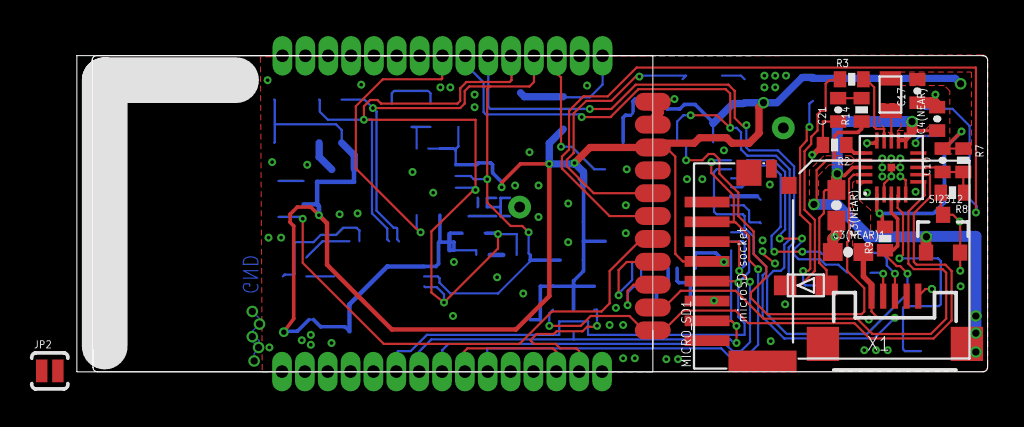
[picture p10: board jnode_v1.brd from above]

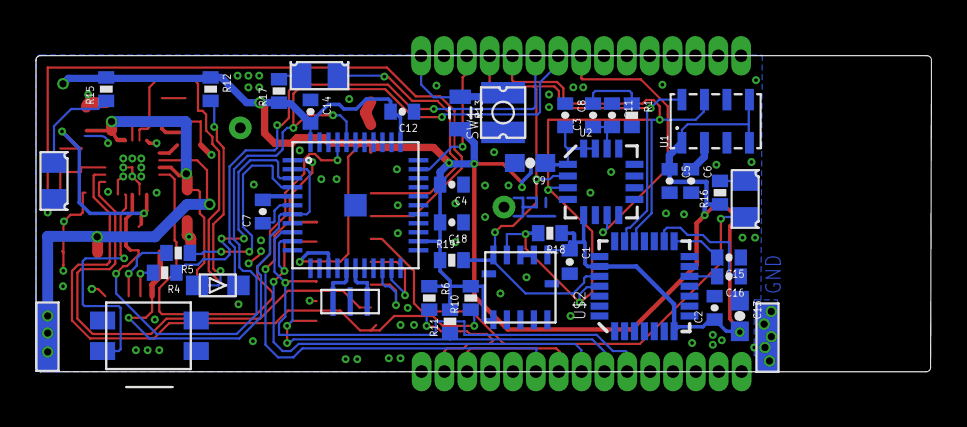
[picture p11: board jnode_v1.brd from below]

Board: 2 copper layers, 49.7 x 17.6 mm, 64 parts (44 on the bottom side), 52 nets.
