teco-kit/Jennisense/(commit log)

2011-08-21 * Added jnsub and jndis hardware schematics.
    [jndis_v1.1.brd, jndis_v1.1.sch, jnusb_v10.brd, jnusb_v10.sch, jnusb_v21.brd, jnusb_v21.sch]
2011-08-23 * Added hello-world-leds example to applications.
2011-10-03 jnusb v30 hardware
    Mickael Bosch contributed a minimal version of the jennic usb board. Leds (not
    used by the firmware), push-buttons and programming header have been removed.
    The programming connector was hardly used and for reprogramming the pads have to
    be directly connected to a serial converter now, which needs to be done only
    once.
    (this design is un-tested)
    [jnusb_v30.brd, jnusb_v30.sch]
2011-10-05 jnode hardware
    Jennic with atmega usb connector, a number of sensors
    (compass,gyro,acc,temp,barometer,ambient light,ir distance,ir leds).
    Design is yet untested.
    [jnode.brd, jnode.sch]
2011-10-07 missing pcb link on jnusb
    between SPISSZ and SPISSM
    [jnusb_v30.brd, jnusb_v30.sch]
2011-10-07 fixed a missing link jnusb
    [jnusb_v30.brd, jnusb_v30.sch]
2012-02-02 jnode quirks
    fix power path for sdcard init without turning off other components
    for atmega bootloader operation:
    HWB hardwired to GND
    jumper on RESET line
    to get into bootloader short the reset line
    [jnode.brd, jnode.sch]
2012-02-02 add very basic imu-serial example for jnode hw
2012-03-09 add atmega32u4 serial firmware
    upload to jnode by toggling the reset pad on the board and uploading with
    dfu-programmer
    [Descriptors.c, USBtoSerial.c, USBtoSerial.h]
2012-03-09 add imu-serial demo
    [jnode.brd]
2012-03-19 update jnode schematic and board
    [jnode_v1.brd, jnode_v1.sch, jnode_v2.brd, jnode_v2.sch]
2012-03-20 fix on the STDBY and BUCK_ON line
    [jnode_v3.sch]
2012-03-21 fix value of I2C pull-ups
    [jnode_v3.sch]
2012-03-30 * Added the Jbee board. The a jennic board compatible to the popular xbee footprint.
    [jbee_jn_oben.brd, jbee_jn_oben.sch, jbee_jn_unten.brd, jbee_jn_unten.sch]
2012-06-25 add button sensor example
    shows how to listen and react on pushbutton events
2012-06-25 also check that event is really from button
2012-07-10 update to eagle 6.2
    [jnode_v2.sch]
2012-07-31 Add the basic jnode-lufa firmware
    [jnode_v3.sch]
2012-11-15 add jnode_v3 layout and v31
    v31 replacess the battery connector to one compatible with the Ipod Video 5g
    battery, which is almost the same size as the jNode.
    [jnode_v3.brd, jnode_v31.brd, jnode_v31.sch]
2012-11-16 lufa update and default baudrate
    switch to newest LUFA.
    configure the default baudrate to 1M, so no caring on PC side is neccesary to
    set the one for talking to the jennic module.
2012-11-16 simplify imu-serial and atmega firmware
2013-01-14 added two basic apllication to receive imu data periodically via IPv6/concom
2013-02-07 * clarified button example to show change of button state
2014-04-06 cc3000 wifi board for jnode
    [jncc3000.brd, jncc3000.sch, jnode_v32.brd, jnode_v32.sch]
2014-06-05 add v33 jnode and cc3000 adapter board
    [jncc3000.brd, jncc3000.sch, jnode_v32.brd, jnode_v33.brd, jnode_v33.sch]
2014-07-05 add pre-test jnode_v34
    [case.scad, case.stl, jncc3000.brd, jncc3000.sch, jnode_v34.brd, jnode_v34.sch]
2014-08-19 update jnode
    [jnode_v34.brd, jnode_v34.sch]
